flatos/antenna_launcher/models/End_Cap_v4.SLDPRT

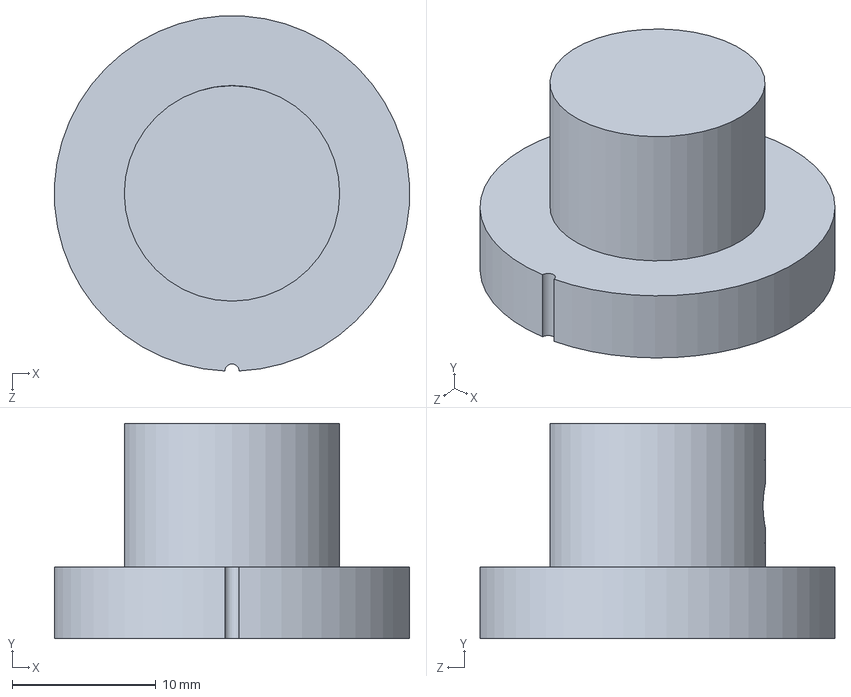
[picture p7: CAD file, 2024-09-02]
models/End_Cap_v4.SLDPRT
24.7 x 15.0 x 24.7 mm
