flatos/antenna_launcher/models/Connector_Clamp.SLDPRT

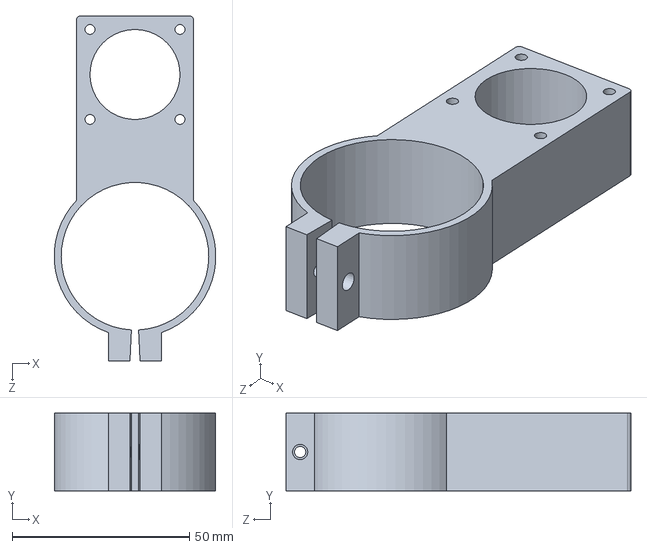
[picture p8: CAD file, 2024-07-31]
models/Connector_Clamp.SLDPRT
45.6 x 22.0 x 97.4 mm
