flatos/antenna_launcher/models/Reel_Clamp.SLDPRT

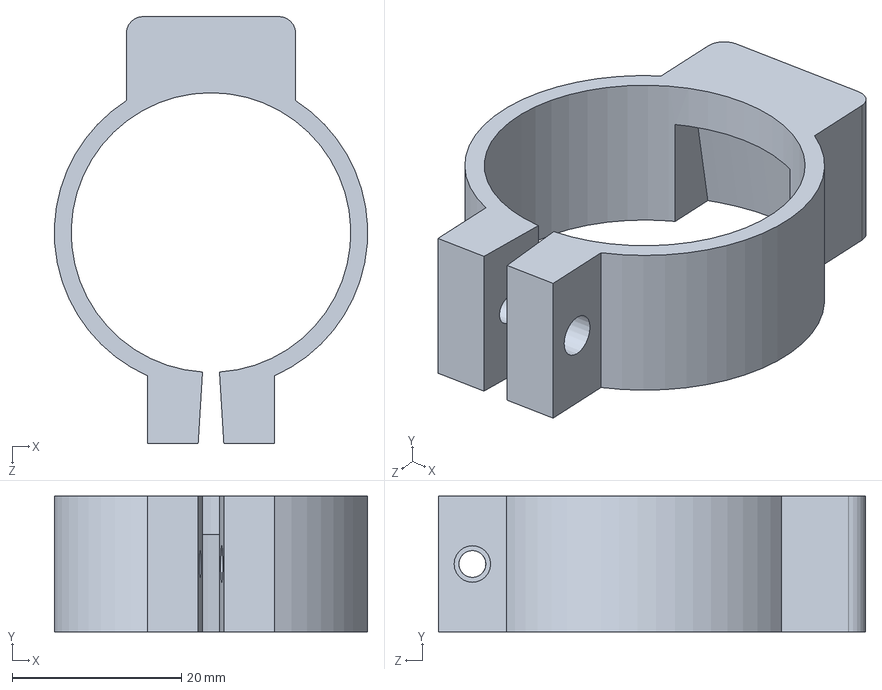
[picture p9: CAD file, 2024-07-31]
models/Reel_Clamp.SLDPRT
37.0 x 16.0 x 50.4 mm
