flatos/antenna_launcher/models/End_Cap_v3a.SLDPRT

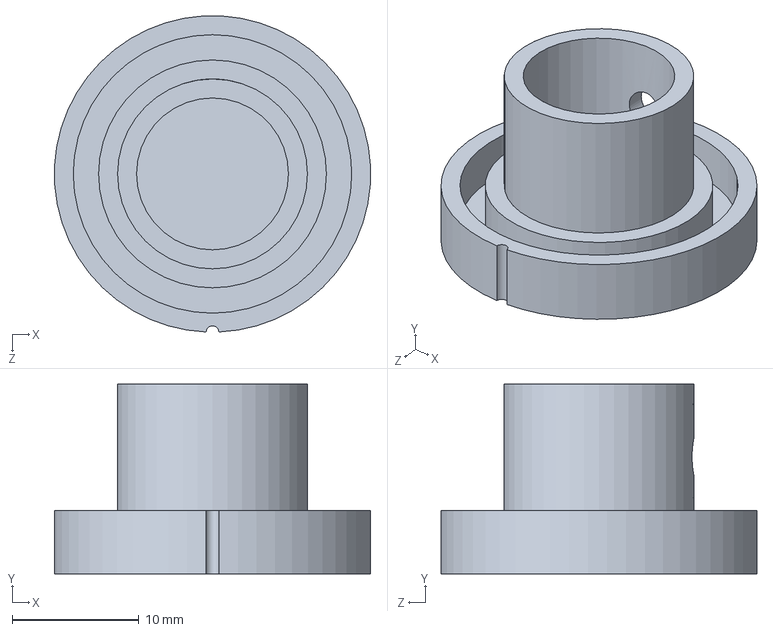
[picture p10: CAD file, 2024-07-31]
models/End_Cap_v3a.SLDPRT
25.0 x 15.0 x 25.0 mm
