flatos/antenna_launcher/(list of files, cad)

Other CAD files:
models/Connector_Clamp.STL
models/End_Cap_v3a.STL
models/End_Cap_v4.STL
models/Reel_Clamp.STL
